lennon101/WalkerStalker/CAD/WalkerStalker Shield/Sensors - Walker St.docx

## Luminosity

Logic level shift for I2C - http://www.adafruit.com/products/757

## Humidity

## Temperature

## Road Temperature

## Sound Level

## optional – Pollutant

## optional – Power metering
