lennon101/WalkerStalker/CAD/TMP006 3D printed bracket/bracketv4.stl

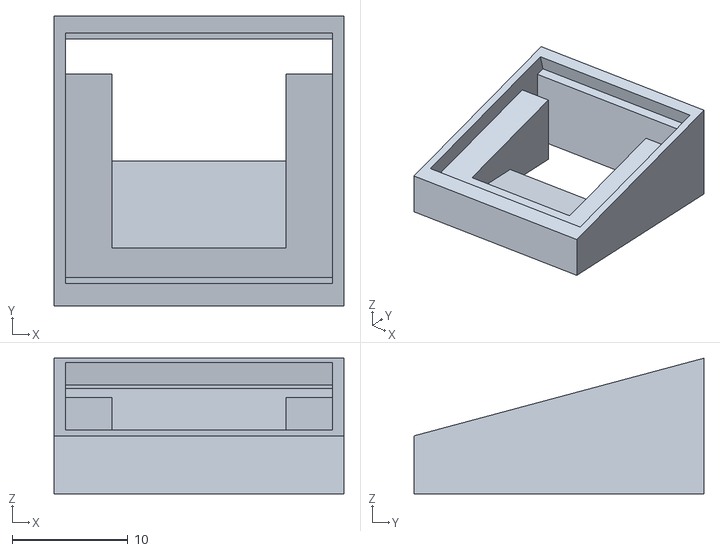
[picture p1: CAD file, 2014-07-14]
CAD/TMP006 3D printed bracket/bracketv4.stl
25.0 x 25.0 x 11.7
