lennon101/WalkerStalker/CAD/RHT03 Housing/RHT v6.stl

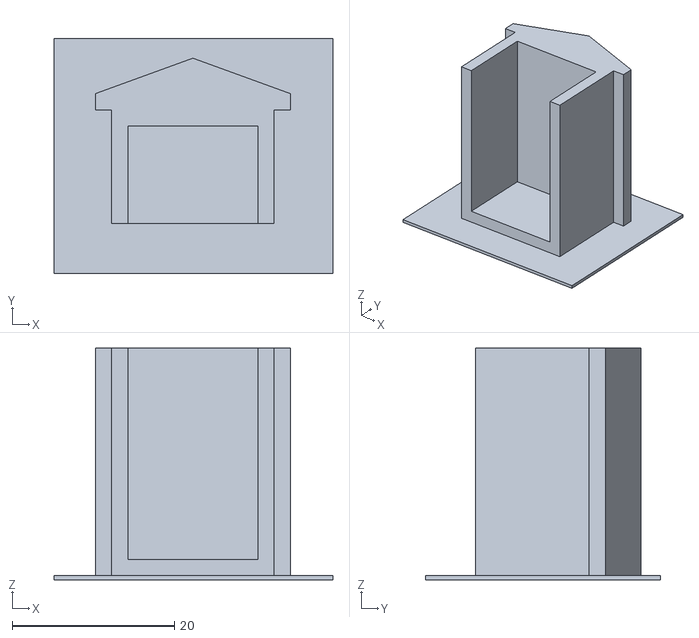
[picture p2: CAD file, 2014-07-30]
CAD/RHT03 Housing/RHT v6.stl
34.3 x 28.9 x 28.5
