lennon101/WalkerStalker/CAD/RHT03 Housing/RHT v4.stl

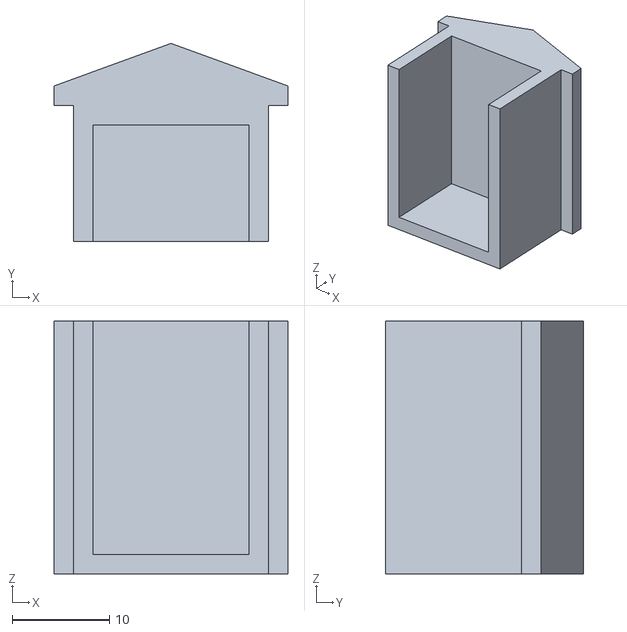
[picture p4: CAD file, 2014-07-30, an earlier design]
CAD/RHT03 Housing/RHT v4.stl
24.0 x 20.4 x 26.0
