lennon101/WalkerStalker/(list of files, cad)

Other CAD files:
CAD/RHT03 Housing/RHT v5.skp
CAD/RHT03 Housing/RHT v6.skp
CAD/RHT03 Housing/RHT03.skp
CAD/RHT03 Housing/Untitled.skp
CAD/TMP006 3D printed bracket/TMP006 mountv2.skp
CAD/TMP006 3D printed bracket/angle.skp
CAD/TMP006 3D printed bracket/bracketv3.skp
CAD/TMP006 3D printed bracket/bracketv4.skp
