lennon101/WalkerStalker/Code/Test Code/GetLog/logOutput.csv

1B501E050000000000EC08FD0000000000D80000760A
1B501E1E0000000000EC08FD0000000000A80000420A
1B501E680000000000EC08FD00000000008400005C0A
1B501E800000000000EC08FD0000000000830000870A
1B501E950000000000EC08FD0000000000C50000640A
