lennon101/WalkerStalker/CAD/WalkerStalker Shield/WalkerStalkerv3.0.brd

## EAGLE design CAD/WalkerStalker Shield/WalkerStalkerv3.0.brd (2015-04-30)

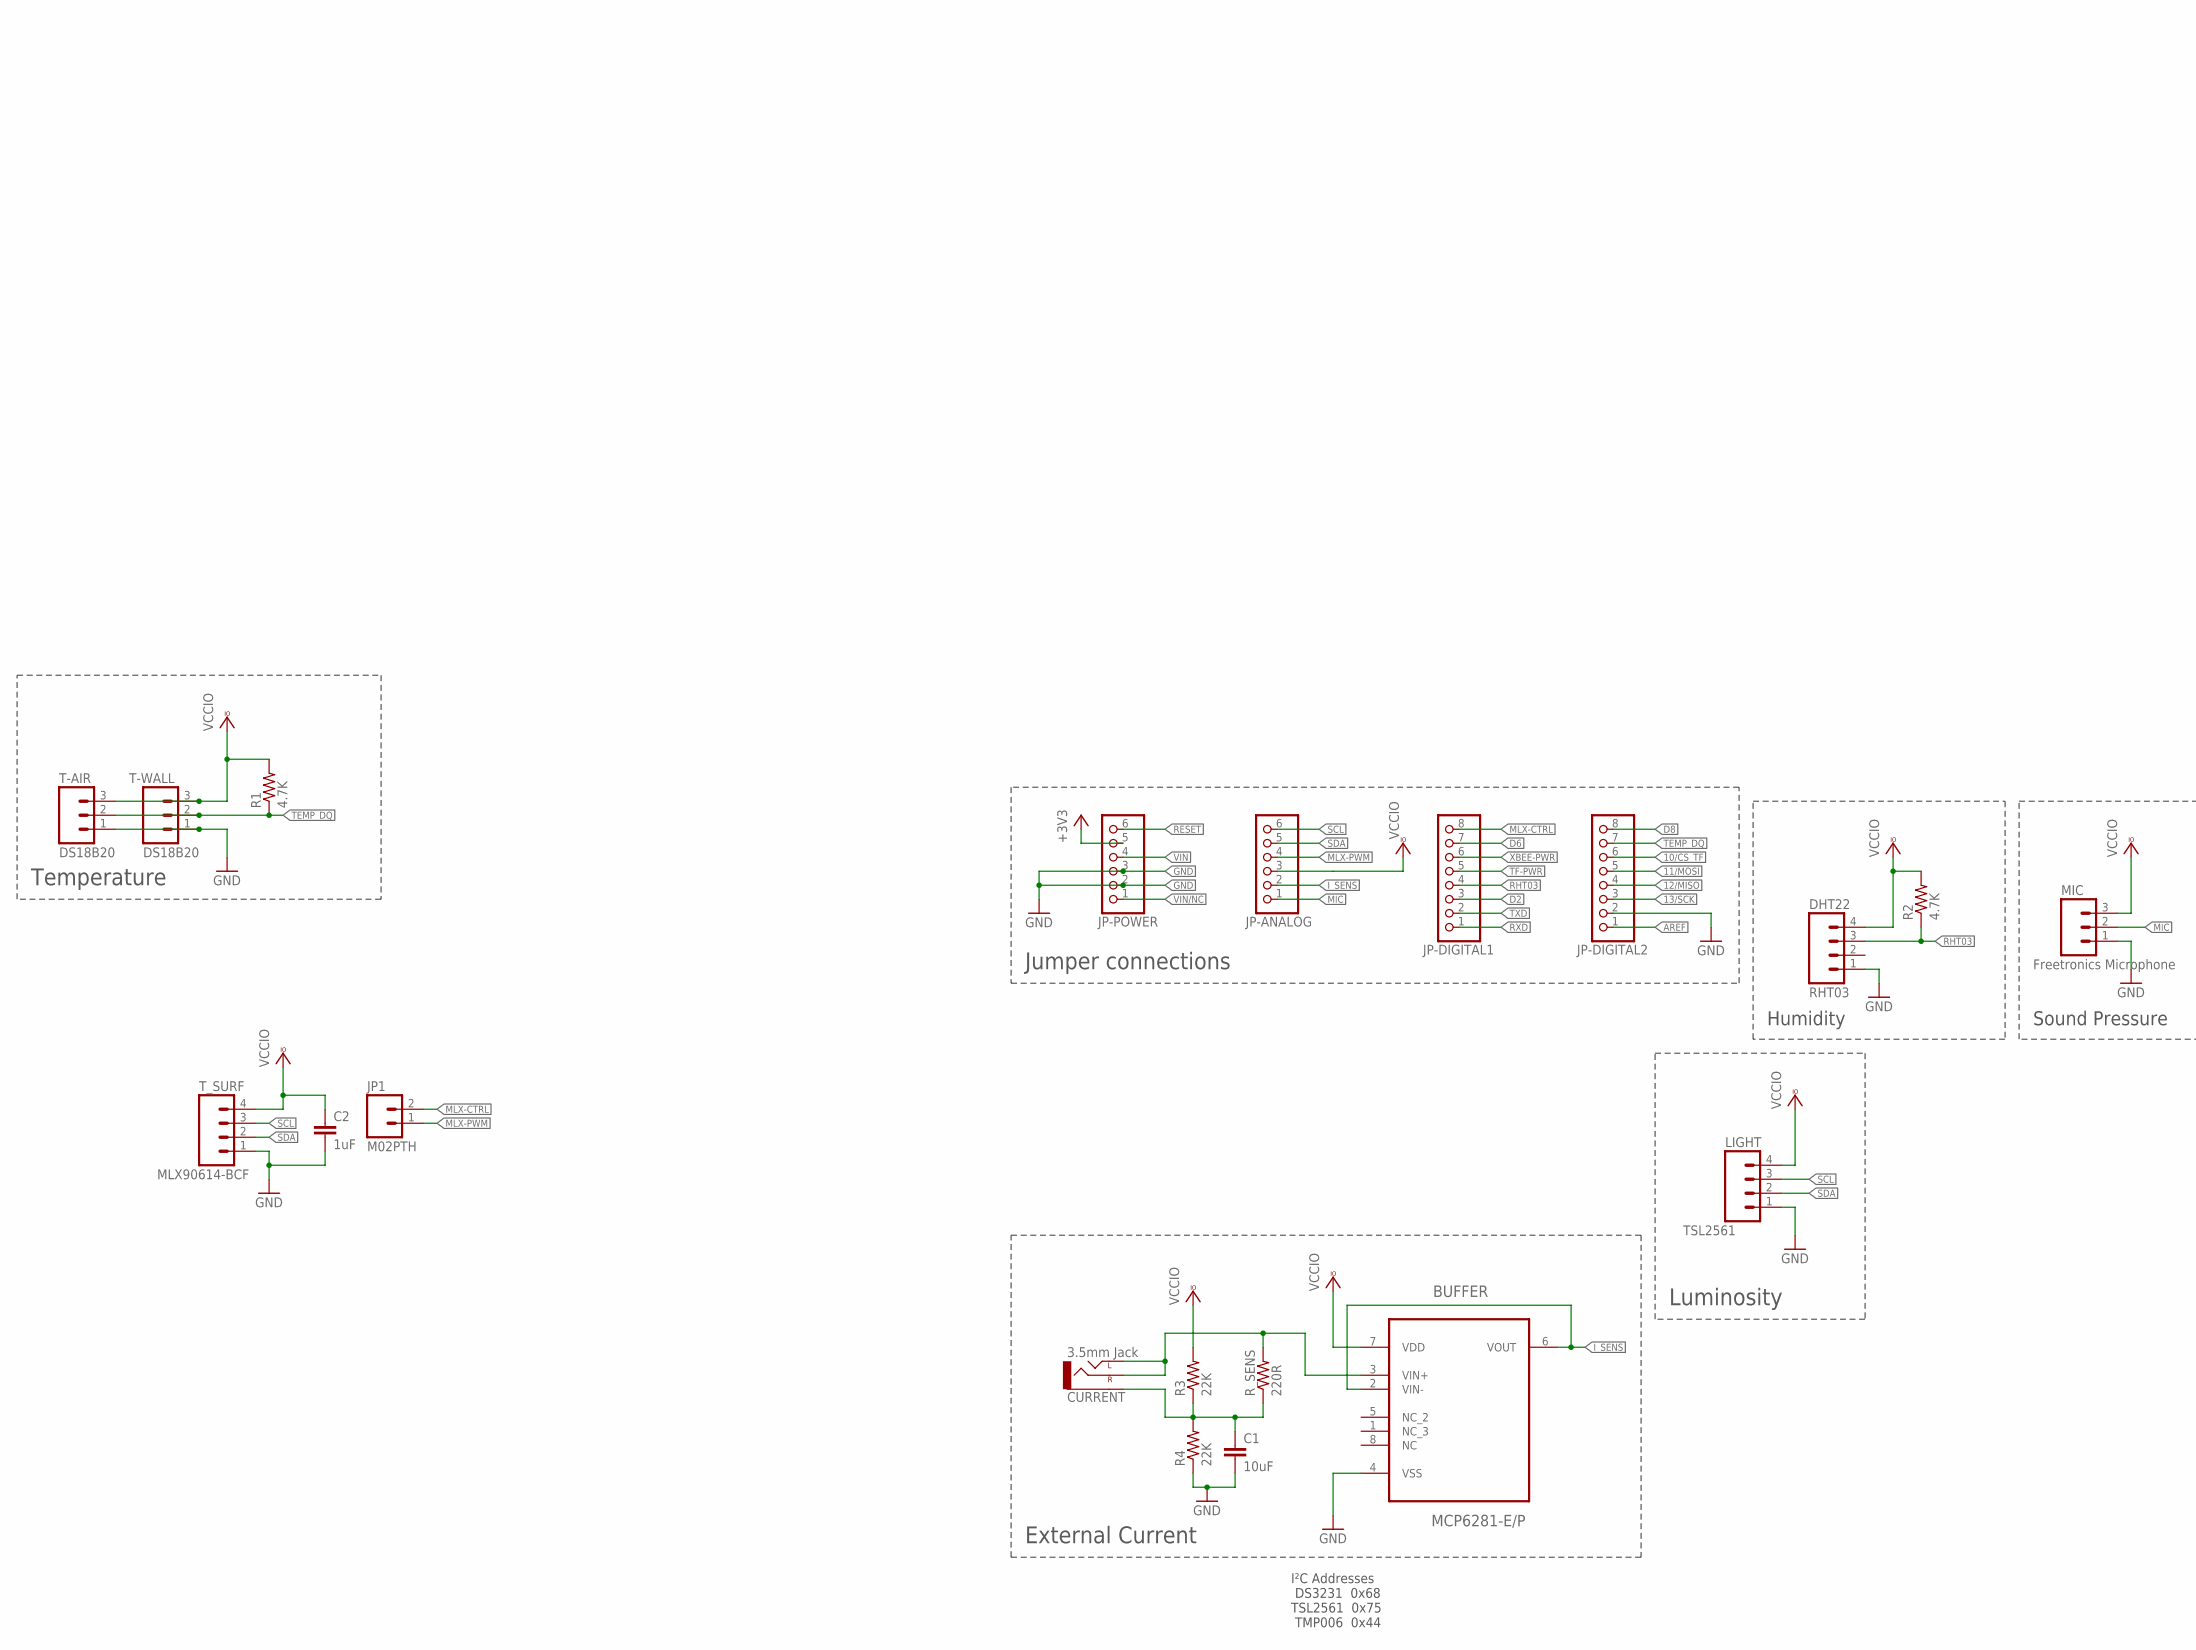
[picture p6: schematic WalkerStalkerv3.0.sch, part in row 1, column 1]

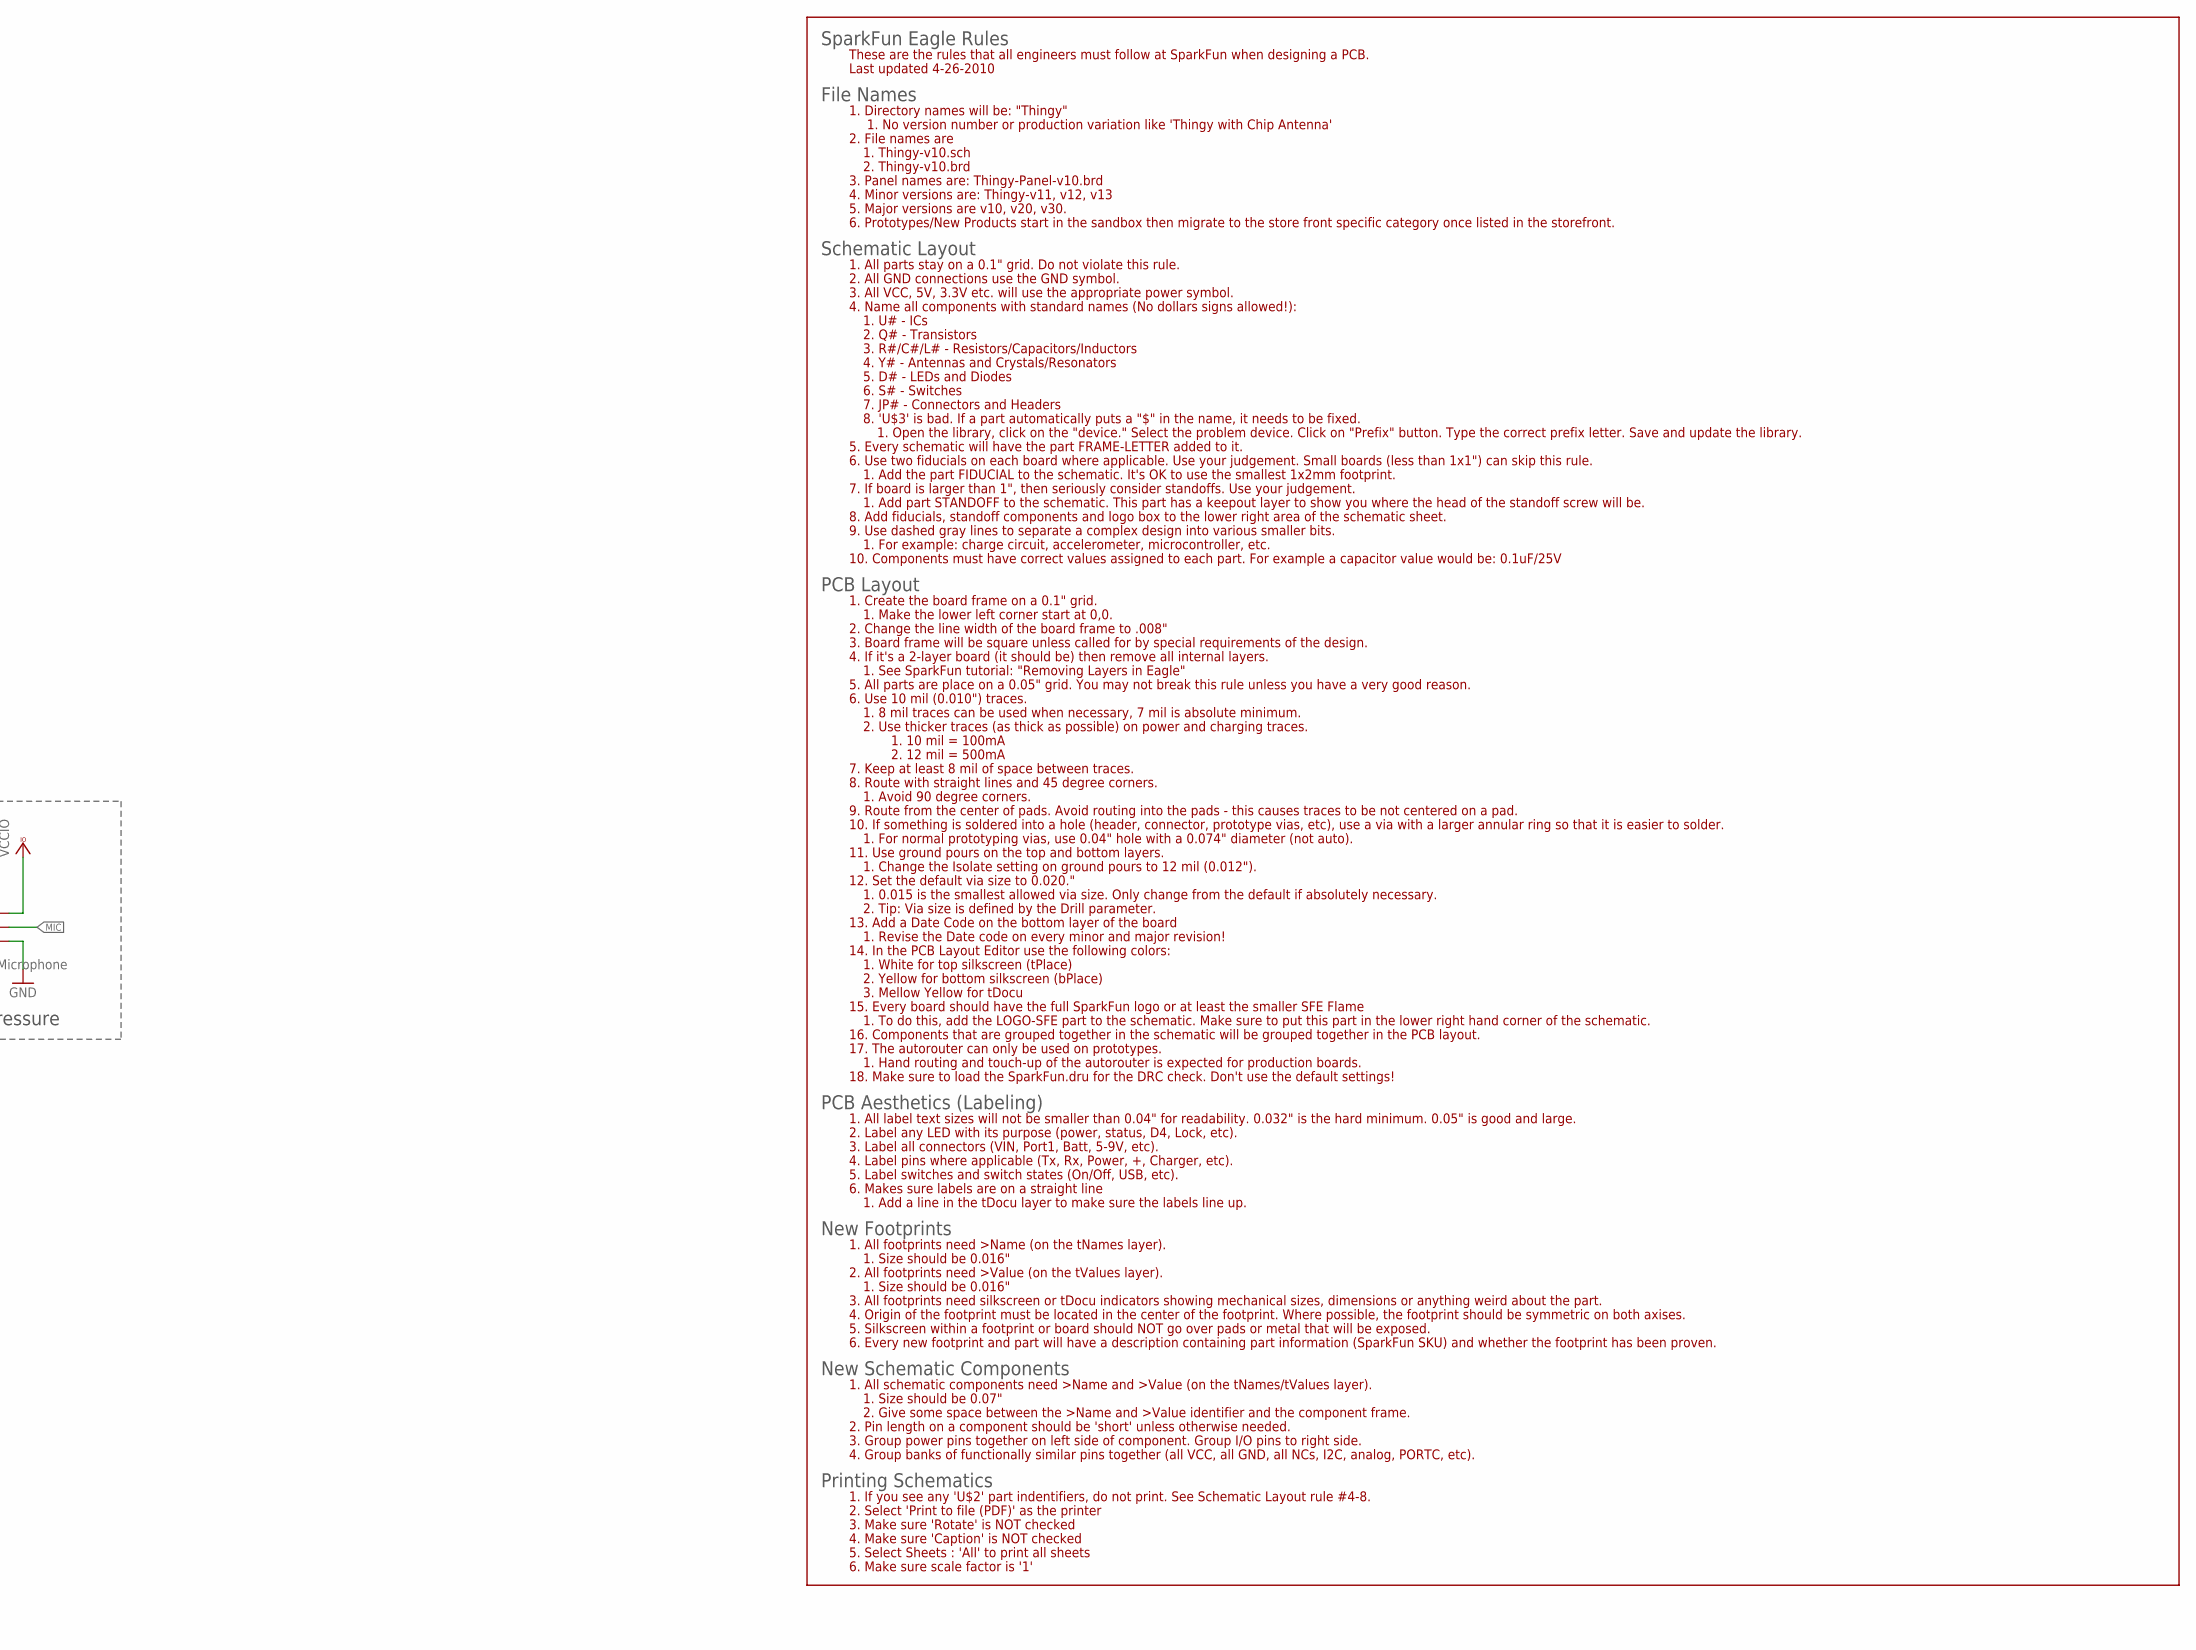
[picture p7: schematic WalkerStalkerv3.0.sch, part in row 1, column 2]

Parts:
BUFFER: MCP6281-E/P; DIP254P762X432-8
C1: 10uF; 1206
C2: 1uF; 1206
CURRENT: 3.5mm Jack; AUDIO-JACK
DHT22: RHT03; 1X04
JP1: M02PTH; 1X02
JP-ANALOG: PINHD-1X6CB; 1X06-CLEANBIG
JP-DIGITAL1, JP-DIGITAL2: PINHD-1X8CLEANBIG; 1X08-CLEANBIG
JP-POWER: PINHD-1X6CB; 1X06-CLEANBIG
LIGHT: TSL2561; 1X04
MIC: Freetronics Microphone; 1X03
R1, R2: 4.7K; 1206
R3, R4: 22K; 1206
R_SENS: 220R; 1206
T-AIR: DS18B20; 1X03
T-WALL: DS18B20; 1X03
T_SURF: MLX90614-BCF; 1X04

Connections:
10/CS_TF: JP-DIGITAL2.6
11/MOSI: JP-DIGITAL2.5
12/MISO: JP-DIGITAL2.4
13/SCK: JP-DIGITAL2.3
+3V3: JP-POWER.5
AREF: JP-DIGITAL2.1
D2: JP-DIGITAL1.3
D6: JP-DIGITAL1.7
D8: JP-DIGITAL2.8
GND: BUFFER.4 (VSS), C1.2, C2.2, DHT22.1, JP-DIGITAL2.2, JP-POWER.2, JP-POWER.3, LIGHT.1, MIC.1, R4.1, T-AIR.1, T-WALL.1, T_SURF.1
I_SENS: BUFFER.2 (VIN-), BUFFER.6 (VOUT), JP-ANALOG.2
MIC: JP-ANALOG.1, MIC.2
MLX-CTRL: JP1.2, JP-DIGITAL1.8
MLX-PWM: JP1.1, JP-ANALOG.4
unnamed: BUFFER.3 (VIN+), CURRENT.RING (RIGHT), CURRENT.TIP (LEFT), R_SENS.2
unnamed: C1.1, CURRENT.SLEEVE, R3.1, R4.2, R_SENS.1
RESET: JP-POWER.6
RHT03: DHT22.3, JP-DIGITAL1.4, R2.1
RXD: JP-DIGITAL1.1
SCL: JP-ANALOG.6, LIGHT.3, T_SURF.3
SDA: JP-ANALOG.5, LIGHT.2, T_SURF.2
TEMP_DQ: JP-DIGITAL2.7, R1.1, T-AIR.2, T-WALL.2
TF-PWR: JP-DIGITAL1.5
TXD: JP-DIGITAL1.2
VCCIO: BUFFER.7 (VDD), C2.1, DHT22.4, JP-ANALOG.3, LIGHT.4, MIC.3, R1.2, R2.2, R3.2, T-AIR.3, T-WALL.3, T_SURF.4
VIN: JP-POWER.4
VIN/NC: JP-POWER.1
XBEE-PWR: JP-DIGITAL1.6

Notes on the sheet:
Jumper connections
External Current
Temperature
Humidity
Luminosity
Sound Pressure
I²C Addresses DS3231 0x68 TSL2561 0x75 TMP006 0x44

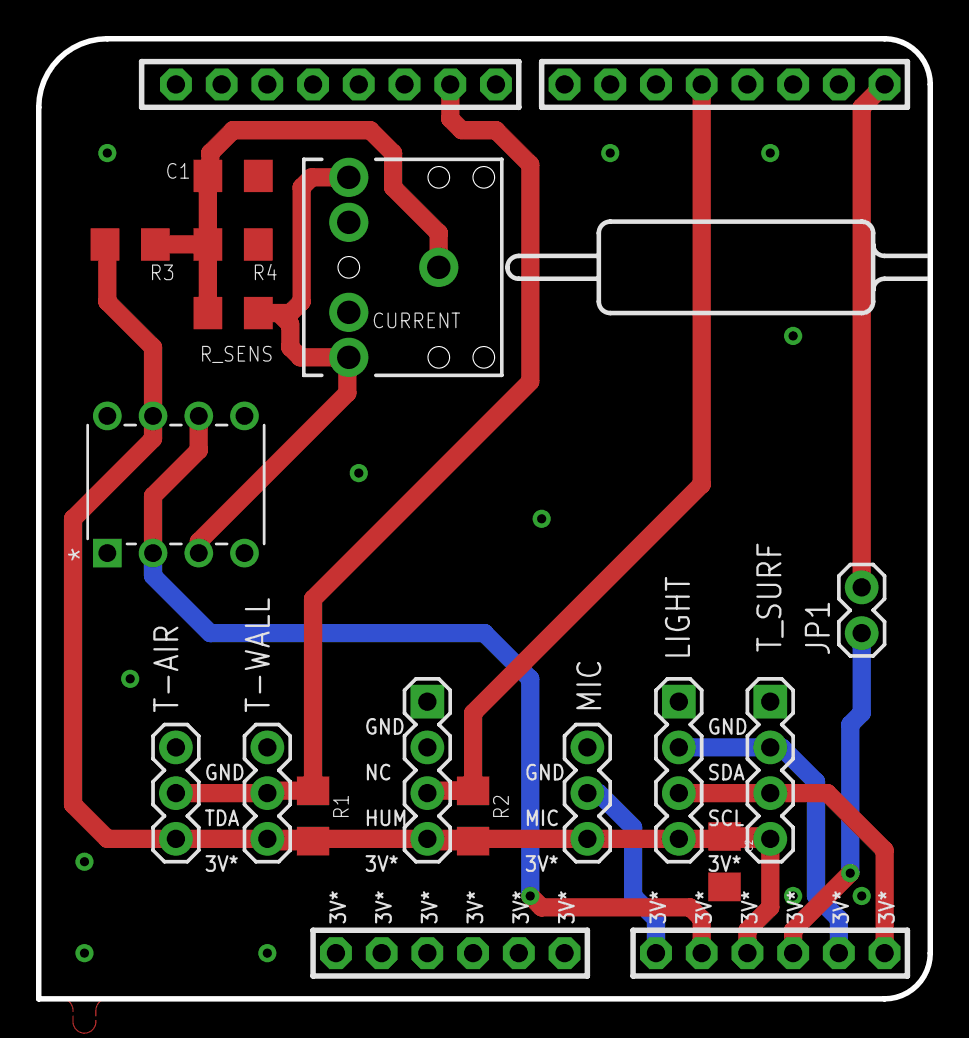
[picture p8: board WalkerStalkerv3.0.brd from above]

Board: 2 copper layers, 49.5 x 53.3 mm, 20 parts (0 on the bottom side), 12 nets.
