lennon101/WalkerStalker/CAD/WalkerStalker Shield/WalkerStalkerv05.brd

## EAGLE design CAD/WalkerStalker Shield/WalkerStalkerv05.brd (2014-07-14)

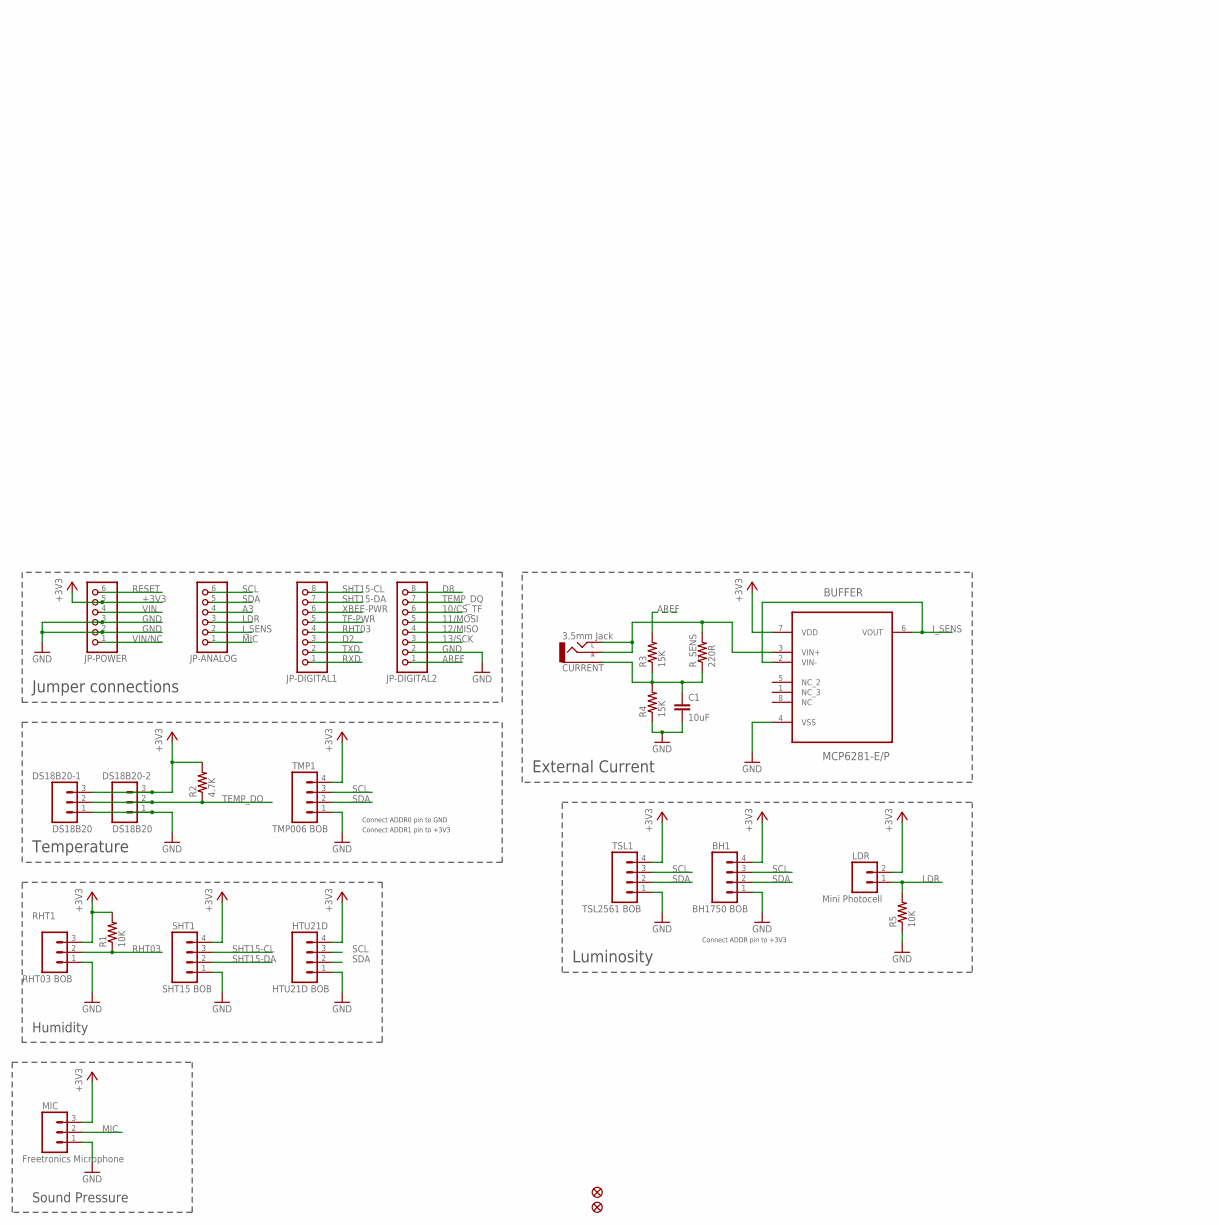
[picture p9: schematic WalkerStalkerv05.sch, part in row 1, column 1]

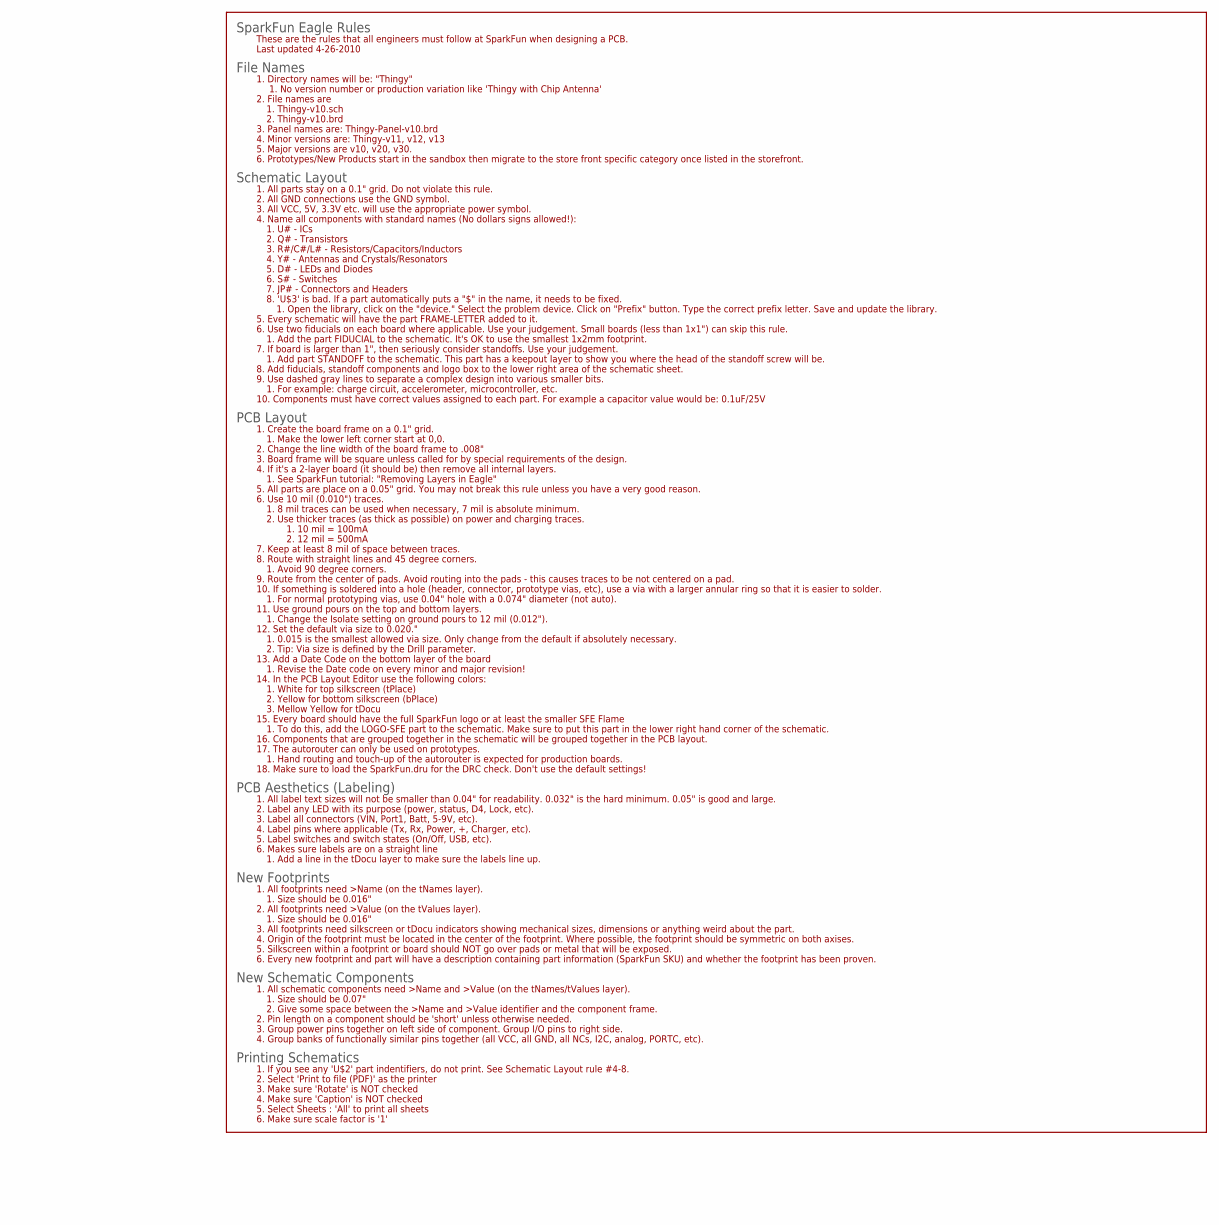
[picture p10: schematic WalkerStalkerv05.sch, part in row 1, column 2]

Parts:
BH1: BH1750 BOB; MOLEX-1X4
BUFFER: MCP6281-E/P; DIP254P762X432-8
C1: 10uF; 1206
CURRENT: 3.5mm Jack; AUDIO-JACK
DS18B20-1, DS18B20-2: DS18B20; MOLEX-1X3
FID1, FID2: FIDUCIAL1.5X3; FIDUCIAL-1.5X3
HTU21D: HTU21D BOB; MOLEX-1X4
JP-ANALOG: PINHD-1X6CB; 1X06-CLEANBIG
JP-DIGITAL1, JP-DIGITAL2: PINHD-1X8CLEANBIG; 1X08-CLEANBIG
JP-POWER: PINHD-1X6CB; 1X06-CLEANBIG
LDR: Mini Photocell; MOLEX-1X2
MIC: Freetronics Microphone; MOLEX-1X3
R1, R5: 10K; 1206
R2: 4.7K; 1206
R3, R4: 15K; 1206
RHT1: RHT03 BOB; MOLEX-1X3
R_SENS: 220R; 1206
SHT1: SHT15 BOB; MOLEX-1X4
TMP1: TMP006 BOB; MOLEX-1X4
TSL1: TSL2561 BOB; MOLEX-1X4

Connections:
10/CS_TF: JP-DIGITAL2.6
11/MOSI: JP-DIGITAL2.5
12/MISO: JP-DIGITAL2.4
13/SCK: JP-DIGITAL2.3
+3V3: BH1.4, BUFFER.7 (VDD), DS18B20-1.3, DS18B20-2.3, HTU21D.4, JP-POWER.5, LDR.2, MIC.3, R1.2, R2.2, RHT1.3, SHT1.4, TMP1.4, TSL1.4
A3: JP-ANALOG.4
AREF: JP-DIGITAL2.1, R3.2
D2: JP-DIGITAL1.3
D8: JP-DIGITAL2.8
GND: BH1.1, BUFFER.4 (VSS), C1.2, DS18B20-1.1, DS18B20-2.1, HTU21D.1, JP-DIGITAL2.2, JP-POWER.2, JP-POWER.3, MIC.1, R4.1, R5.1, RHT1.1, SHT1.1, TMP1.1, TSL1.1
I_SENS: BUFFER.2 (VIN-), BUFFER.6 (VOUT), JP-ANALOG.2
LDR: JP-ANALOG.3, LDR.1, R5.2
MIC: JP-ANALOG.1, MIC.2
unnamed: BUFFER.3 (VIN+), CURRENT.RING (RIGHT), CURRENT.TIP (LEFT), R_SENS.2
unnamed: C1.1, CURRENT.SLEEVE, R3.1, R4.2, R_SENS.1
RESET: JP-POWER.6
RHT03: JP-DIGITAL1.4, R1.1, RHT1.2
RXD: JP-DIGITAL1.1
SCL: BH1.3, HTU21D.3, JP-ANALOG.6, TMP1.3, TSL1.3
SDA: BH1.2, HTU21D.2, JP-ANALOG.5, TMP1.2, TSL1.2
SHT15-CL: JP-DIGITAL1.8, SHT1.3
SHT15-DA: JP-DIGITAL1.7, SHT1.2
TEMP_DQ: DS18B20-1.2, DS18B20-2.2, JP-DIGITAL2.7, R2.1
TF-PWR: JP-DIGITAL1.5
TXD: JP-DIGITAL1.2
VIN: JP-POWER.4
VIN/NC: JP-POWER.1
XBEE-PWR: JP-DIGITAL1.6

Notes on the sheet:
Jumper connections
External Current
Temperature
Humidity
Luminosity
Sound Pressure
Connect ADDR pin to +3V3
Connect ADDR0 pin to GND
Connect ADDR1 pin to +3V3

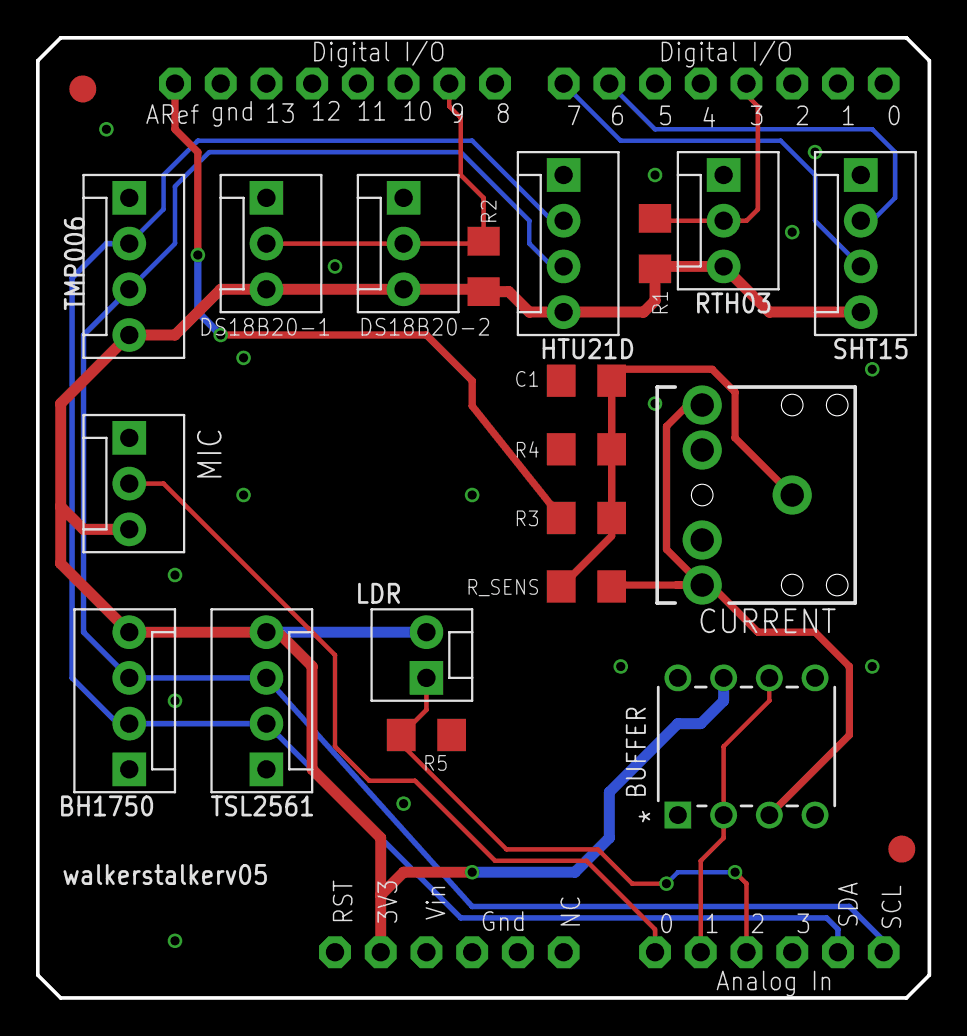
[picture p11: board WalkerStalkerv05.brd from above]

Board: 2 copper layers, 49.5 x 53.3 mm, 25 parts (0 on the bottom side), 14 nets.
