lennon101/WalkerStalker/CAD/WalkerStalker Shield/WalkerStalkerv0.brd

## EAGLE design CAD/WalkerStalker Shield/WalkerStalkerv0.brd (2014-04-16)

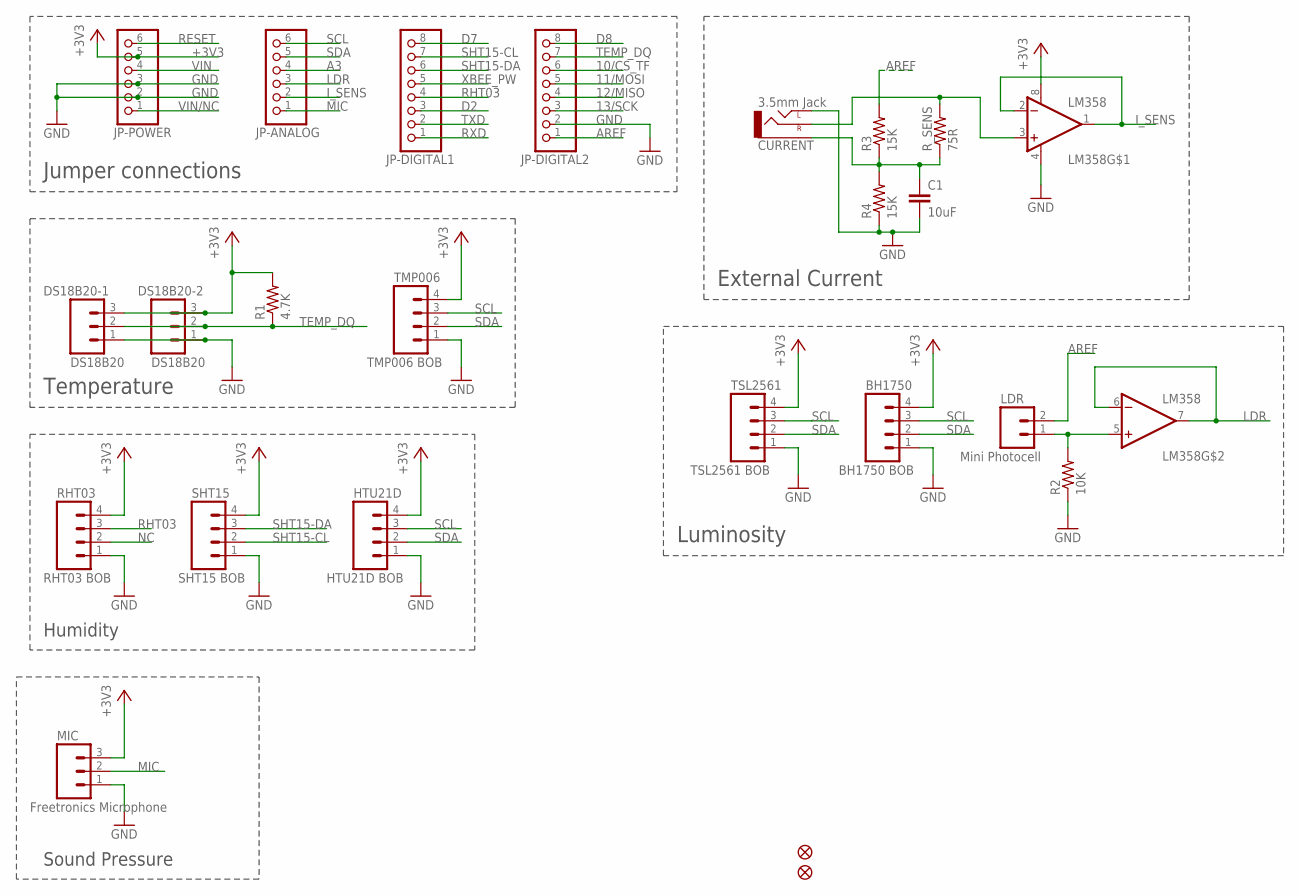
[picture p12: schematic WalkerStalkerv0.sch]

Parts:
BH1750: BH1750 BOB; MOLEX-1X4
C1: 10uF; 1206
CURRENT: 3.5mm Jack; AUDIO-JACK
DS18B20-1, DS18B20-2: DS18B20; MOLEX-1X3
FID1, FID2: FIDUCIAL1.5X3; FIDUCIAL-1.5X3
HTU21D: HTU21D BOB; MOLEX-1X4
JP-ANALOG: PINHD-1X6CB; 1X06-CLEANBIG
JP-DIGITAL1, JP-DIGITAL2: PINHD-1X8CLEANBIG; 1X08-CLEANBIG
JP-POWER: PINHD-1X6CB; 1X06-CLEANBIG
LDR: Mini Photocell; MOLEX-1X2
LM358: LM358; DIP08
MIC: Freetronics Microphone; MOLEX-1X3
R1: 4.7K; 1206
R2: 10K; 1206
R3, R4: 15K; 1206
RHT03: RHT03 BOB; MOLEX-1X4
R_SENS: 75R; 1206
SHT15: SHT15 BOB; MOLEX-1X4
TMP006: TMP006 BOB; MOLEX-1X4
TSL2561: TSL2561 BOB; MOLEX-1X4

Connections:
10/CS_TF: JP-DIGITAL2.6
11/MOSI: JP-DIGITAL2.5
12/MISO: JP-DIGITAL2.4
13/SCK: JP-DIGITAL2.3
+3V3: BH1750.4, DS18B20-1.3, DS18B20-2.3, HTU21D.4, JP-POWER.5, LM358.8 (V+), MIC.3, R1.2, RHT03.4, SHT15.4, TMP006.4, TSL2561.4
A3: JP-ANALOG.4
AREF: JP-DIGITAL2.1, LDR.2, R3.2
D2: JP-DIGITAL1.3
D7: JP-DIGITAL1.8
D8: JP-DIGITAL2.8
GND: BH1750.1, C1.2, CURRENT.TIP (LEFT), DS18B20-1.1, DS18B20-2.1, HTU21D.1, JP-DIGITAL2.2, JP-POWER.2, JP-POWER.3, LM358.4 (V-), MIC.1, R2.1, R4.1, RHT03.1, SHT15.1, TMP006.1, TSL2561.1
I_SENS: JP-ANALOG.2, LM358.1 (OUT), LM358.2 (-IN)
LDR: JP-ANALOG.3, LM358.6 (-IN), LM358.7 (OUT)
LDR_OUT: LDR.1, LM358.5 (+IN), R2.2
MIC: JP-ANALOG.1, MIC.2
N$: CURRENT.RING (RIGHT), LM358.3 (+IN), R_SENS.2
unnamed: C1.1, CURRENT.SLEEVE, R3.1, R4.2, R_SENS.1
NC: RHT03.2
RESET: JP-POWER.6
RHT03: JP-DIGITAL1.4, RHT03.3
RXD: JP-DIGITAL1.1
SCL: BH1750.3, HTU21D.3, JP-ANALOG.6, TMP006.3, TSL2561.3
SDA: BH1750.2, HTU21D.2, JP-ANALOG.5, TMP006.2, TSL2561.2
SHT15-CL: JP-DIGITAL1.7, SHT15.2
SHT15-DA: JP-DIGITAL1.6, SHT15.3
TEMP_DQ: DS18B20-1.2, DS18B20-2.2, JP-DIGITAL2.7, R1.1
TXD: JP-DIGITAL1.2
VIN: JP-POWER.4
VIN/NC: JP-POWER.1
XBEE_PW: JP-DIGITAL1.5

Notes on the sheet:
Jumper connections
External Current
Temperature
Humidity
Luminosity
Sound Pressure

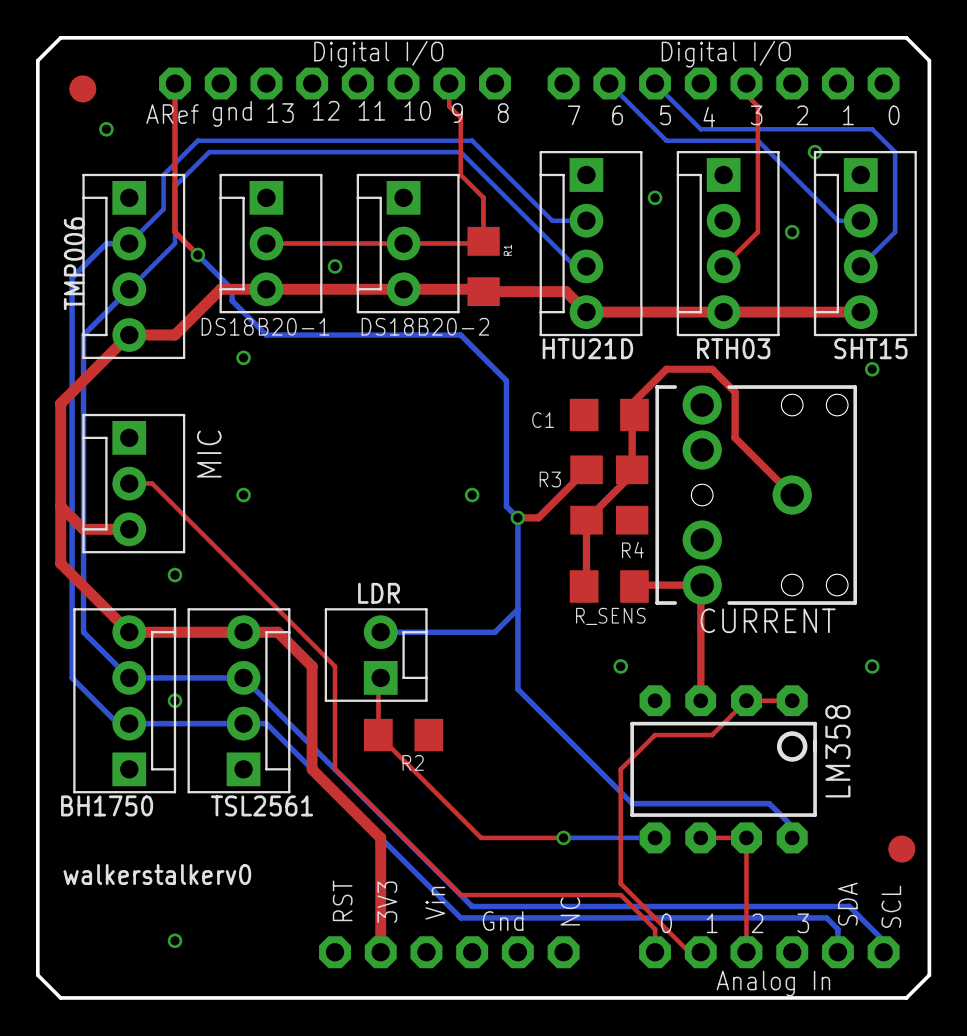
[picture p13: board WalkerStalkerv0.brd from above]

Board: 2 copper layers, 49.5 x 53.3 mm, 24 parts (0 on the bottom side), 15 nets.
