lennon101/WalkerStalker/Code/Test Code/Stalkerv20/.TinyBlink.vsarduino.h

/* 
	Editor: http://www.visualmicro.com
	        arduino debugger, visual micro +, free forum and wiki
	
	Hardware: ATtiny84 @ 1 MHz  (internal oscillator; BOD disabled), Platform=avr, Package=tiny
*/

#define __AVR_ATtiny84__
#define __AVR_ATTINY84__
#define ARDUINO 101
#define ARDUINO_MAIN
#define F_CPU 1000000L
#define __AVR__
#define __cplusplus
extern "C" void __cxa_pure_virtual() {;}

//
//
void doSomething();

#include "c:\Program Files (x86)\Arduino\hardware\tiny\avr\cores\tiny\arduino.h"
#include "E:\Dropbox\Projects\Wireless Game Buzzers\TinyBlink\TinyBlink.ino"
