lennon101/WalkerStalker/(commit log)

2014-04-15 Improved serial output
    - Removed old and redundant code
    - Printed/Transmitted sensor data is easier to read at the expense of a
    few extra bytes in each packet
    - Sound level output is now an average rather than maximum, as averages
    give more accurate conversions
    - Printing the time now pads a zero to the seconds if needed
2014-04-16 HTU21D Library fixed
    [WalkerStalkerv0.brd, WalkerStalkerv0.sch, WalkerStalkerv01.brd, WalkerStalkerv01.sch, WalkerStalkerv02.brd, WalkerStalkerv02.sch, WalkerStalkerv03.brd, WalkerStalkerv03.sch]
2014-04-26 Prototype Update
    - Prototype deployment code added (Stalkerv02)
    - Production code cloned in preparation for the next version of the
    sensor module
    - WalkerStalker code greatly optimised since last update
2014-05-07 v20 Update
    - Removed some sensors (SHT15, RHT03, LDR, BH1750FVI)
    - Transmission now occurs in packets for reduced redundancy
    - Current consumption & sound are now active again
    - XBee transmission is now in API mode, and in packets
2014-07-14 Fixed Temperature sensors
    + Temperature sensors are now called by explicit address, rather than
    index, which was not consistent (could not tell if sensor was wall or
    air)
    + Unit IDs are not transmitted in data packets for easy identification
    +Mounting bracket for TMP006 sensor added (3D file)
    [TMP006 mountv2.skp, WalkerStalkerv04.brd, WalkerStalkerv04.sch, WalkerStalkerv05.brd, WalkerStalkerv05.sch, WalkerStalkerv20.brd, WalkerStalkerv20.sch, WalkerStalkerv21.brd]
2014-07-30 New folder structure
    + Changed the sample delay window to 20s
    [LOG.CSV, RHT v3.stl, RHT v4.stl, RHT v5.skp, RHT v5.stl, RHT v6.skp, RHT v6.stl, RHT03.skp]
2014-08-14 Added debug output to v20 code
    + Changed the address of the coordinator to the default address to let
    the network sort itself out
    - Removed a lot of useless receive code from the xbee transmit function
    [2014.04.16 - LOG.csv, After HTU21D Fix.csv, Battery-Solar Capacity.xlsx, Current Sense Calculator.xlsx, Current Sensor Test Results.xlsx, KARL_RAW.csv, KARL_RAW.xlsx, Slope.xlsx]
2014-11-05 Attempted auto-retry for XBee transmission
    [Current Sense Calculator.xlsx, Current Sensor Test Results.xlsx, Stalker power consumption with XBee disconnected.csv, Stalker power consumption with XBee disconnected.xlsx, Stalker.csv, Stalker2.csv]
2015-04-30 Not sure
    [WalkerStalkerv0.brd, WalkerStalkerv0.sch, WalkerStalkerv01.brd, WalkerStalkerv01.sch, WalkerStalkerv02.brd, WalkerStalkerv02.sch, WalkerStalkerv03.brd, WalkerStalkerv03.sch]
2015-05-01 Moving folders around for clarity
    [LOG.CSV, WalkerStalkerv3.0.sch, logOutput.csv]
2015-05-01 Cleaning up folders
    [KARL_RAW.csv, KARL_RAW.xlsx, Slope.xlsx, WalkerStalkerv3.0.sch, speedtest.csv]
2015-05-01 More cleaning
    [2014.04.16 - LOG.csv, After HTU21D Fix.csv, Battery-Solar Capacity.xlsx, Current Sense Calculator.xlsx, Current Sensor Test Results.xlsx, Sound Level Calibration.xlsx, Sound Test.xlsx, Stalker - 20ms.csv]
